Seyer24/Proyecto-Final-OC/README.md

# Proyecto-Final-OC
Oximetro Casero ESP32- MAX30102- OLED

Que es un oximetro?
El oxímetro de pulso es un dispositivo que mide el nivel de oxígeno en la sangre de forma no invasiva. Funciona mediante haces de luz que atraviesan el dedo, permitiendo estimar el porcentaje de oxígeno presente en los glóbulos rojos. 
imagen

Lista de materiales:
imagen

Explicacion de componentes:
imagen

Circuito:

imagen

Prototipo en Protoboard:

imagen

Prototipo Final:

imagen

Conclusion:

En conclusión, este proyecto evidencia como los avances en ingeniería han permitido desarrollar dispositivos médicos accesibles y funcionales en cuanto el monitoreo de signos vitales.
Dispositivos como el oxímetro de pulso, aunque aparentemente simples, permiten evaluar parámetro esenciales para la salud y apoyar la detección y seguimiento de alteraciones clínicas en millones de personas. 
Esto nos demuestra el impacto que la tecnología puede tener en la medicina y en el acceso al cuidado de la salud. 
Esto da como resultado una armonía entre proyectos IoT y la medicina. Ya que cualquier persona podría crear proyectos relacionados con la medicina y poder obtener respuestas a padecimientos con la ayuda tecnológica.
