Seyer24/Proyecto-Final-OC/Oximetro ESP32.pdf

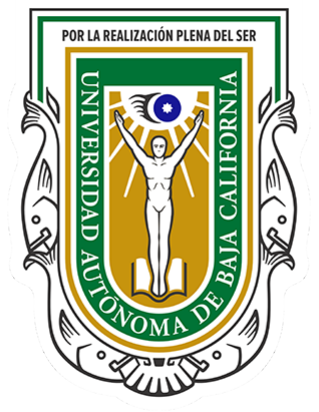
[picture p23: figure]

### Universidad Autónoma de Baja California (UABC)

Facultad de Ciencias de la Ingeniería y Tecnología (FCITEC)

Ingeniería en Desarrollo de Software

# Proyecto Final

## Monitor Cardíaco IoT con ESP32 y MAX30102

Asignatura: Organización de Computadoras

Semestre: 2026-1

Grupo: Grupo 534

Profesor: M.C. Jose Manuel Muñóz Contreras

Alumno: Reyes Gonzalez Arath — 1293182

Valle de las Palmas, Baja California, 13 de mayo de 2026

### Resumen

En este proyecto se diseño e implemento un monitor cardiaco portatil basado en el microcontrolador ESP32 [1] y el sensor optico MAX30102 [2], capaz de medir la frecuencia cardiaca (BPM) y la saturacion de oxigeno en sangre (SpO2) mediante fotopletismografia [3]. El sistema muestra los resultados en tiempo real sobre una pantalla OLED SSD1306 [4] mediante el protocolo I2C [5], y transmite los datos hacia Google Sheets a traves de WiFi y un Google Apps Script [6]. Adicionalmente, el ESP32 actua como ser-

vidor web embebido que expone un dashboard accesible desde cualquier dispositivo en la misma red [7]. El dispositivo evoluciono desde un prototipo en protoboard hasta una

version portatil alimentada por una bateria LiPo de 3.7V, un modulo cargador TP4056
[8] y un convertidor elevador MT3608 [9] que suministra 5V regulados al ESP32.

### Abstract

This project involved the design and implementation of a portable cardiac monitor based on the ESP32 microcontroller and the MAX30102 optical sensor, capable of measuring heart rate (BPM) and blood oxygen saturation (SpO2) through photoplethys-

mography. The system displays real-time results on an SSD1306 OLED screen via the I2C protocol and transmits data to Google Sheets through WiFi and a Google Apps Script. Additionally, the ESP32 acts as an embedded web server exposing a real-time dashboard. The device evolved from a breadboard prototype to a portable version powered by a 3.7V LiPo battery, a TP4056 USB-C charging module, and an MT3608 boost converter supplying 5V to the ESP32.

Palabras clave: MAX30102, ESP32, IoT, BPM, SpO2, OLED, I2C, Google Sheets, LiPo.

1

### Tabla de Contenido

1. Introducción | 4
2. Objetivos | 4
3. Marco Teórico | 5
4. Materiales y Equipos | 7
5. Diseño del Sistema | 8
6. Metodología y Desarrollo | 9
7. Resultados y Discusión | 14

2

8. Problemas Encontrados y Soluciones | 17
9. Conclusión | 17

3

Organización de Computadoras – UABC FCITEC Proyecto Final: Monitor Cardiaco IoT

### 1. Introducción

El monitoreo de signos vitales ha sido historicamente una tarea restringida al ambito clinico, requiriendo equipos costosos y personal especializado. Sin embargo, la convergencia entre microcontroladores de bajo costo con conectividad inalambrica integrada, sensores opticos miniaturizados y plataformas de almacenamiento en la nube ha democratizado el acceso a esta tecnologia, permitiendo la construccion de dispositivos medicos orientados al Internet de las Cosas (IoT).

El presente proyecto integra el microcontrolador ESP32 [1] con el sensor MAX30102 [2], un dispositivo de fotopletismografia (PPG) que utiliza LEDs infrarrojos y rojos para detectar variaciones en la absorcion de luz producidas por el flujo sanguineo [3].

Esta tecnica permite estimar de forma no invasiva tanto la frecuencia cardiaca como la saturacion de oxigeno en sangre periferica (SpO2), dos indicadores fundamentales del

estado cardiovascular y respiratorio del paciente.

Desde la perspectiva de la Organizacion de Computadoras, el proyecto ilustra como los principios arquitectonicos de un sistema embebido —gestion de buses I2C [5], [10], control de perifericos GPIO [11], polling y comunicacion en red— se materializan en

un sistema funcional. El ciclo de desarrollo, desde la validacion en protoboard hasta un dispositivo portatil con servidor web embebido [7], reproduce fielmente el proceso

de ingenieria de hardware embebido en proyectos reales.

### 2. Objetivos

### 2.1 Objetivo general

Disenar, implementar y validar un sistema embebido portatil de monitoreo cardiaco no invasivo que, mediante el microcontrolador ESP32 [1] y el sensor MAX30102 [2], adquiera senales de fotopletismografia [3] para calcular la frecuencia cardiaca promedio y la SpO2, visualice los resultados en una pantalla OLED SSD1306 [4] en tiempo real y los transmita a Google Sheets [6] mediante WiFi; superando los retos de soldadura confiable, calibracion iterativa del firmware [12] e integracion del sistema de alimentacion portatil [8], [9].

### 2.2 Objetivos específicos

Configurar Arduino IDE 2.3.8 con el soporte ESP32 [7] y las librerias Adafruit_SSD1306

[13], Adafruit_GFX [14], MAX30105 [12] y ArduinoJson [15].

2026-1 | 4

Establecer comunicacion I2C [5] usando GPIO21 (SDA) y GPIO22 (SCL) [10], [11].

Ajustar iterativamente el algoritmo checkForBeat y calculo de SpO2 [2], [12].

Disenar una maquina de estados con cuatro fases: espera, medicion de 60 s, presentacion y transmision de datos.

Integrar WiFi para Google Sheets [6] y dashboard web embebido [7].

Evolucionar el prototipo a dispositivo portatil con bateria LiPo, TP4056 [8] y MT3608 [9].

### 2.3 Competencias a desarrollar

Aplicar principios de arquitectura de computadoras en sistemas embebidos con bus I2C [5].

Integrar hardware y software para adquisicion, procesamiento y transmision de senales biomedicas en IoT.

Resolver problemas practicos de fabricacion: soldaduras, distribucion de potencia y seleccion de componentes.

Documentar tecnicamente el proceso iterativo de desarrollo hasta la version portatil.

### 3. Marco Teórico

### 3.1 Microcontrolador ESP32 y configuración de pines GPIO

El ESP32 es un sistema en chip (SoC) desarrollado por Espressif Systems que integra un procesador Xtensa LX6 de doble nucleo a 240 MHz, 520 KB de SRAM, conectividad WiFi IEEE 802.11 b/g/n y Bluetooth 4.2 [1]. Dispone de 34 pines GPIO programables con funciones multiplexadas que incluyen I2C, SPI, UART, ADC y PWM [11].

Para este proyecto se utilizaron GPIO21 y GPIO22 como bus I2C principal. Esta eleccion no es arbitraria: el Technical Reference Manual del ESP32 [16] establece que estos

pines son los predeterminados para el periferico I2C 0, lo que significa que el framework de Arduino para ESP32 [7] los inicializa automaticamente con Wire.begin() sin

necesidad de especificar pines adicionales, reduciendo conflictos con otras funciones del chip. El pin VIN acepta entre 4.5V y 5.5V y alimenta el regulador lineal interno que genera los 3.3V para el nucleo y los perifericos [1].

### 3.2 Sensor MAX30102 — Fotopletismografía

El MAX30102 es un modulo integrado de oximetria de pulso y monitoreo de frecuencia cardiaca [2]. Incorpora dos LEDs (rojo a 660 nm e infrarrojo a 880 nm), un fotode-

tector de alta sensibilidad y electronica de acondicionamiento en un encapsulado de 5.6 mm × 3.3 mm. La comunicacion es por I2C en la direccion fija 0x57.

El principio se basa en la fotopletismografia (PPG), tecnica no invasiva que mide variaciones en el volumen sanguineo mediante absorcion diferencial de luz [3]. La libreria MAX30105 de SparkFun [12], disponible en GitHub, implementa el algoritmo

maxim_heart_rate_and_oxygen_saturation() para calcular SpO2 y checkForBeat() para deteccion de latidos.

### 3.3 Protocolo I2C y justificación de su uso

El bus I2C (Inter-Integrated Circuit) es un protocolo serie sincrono de dos hilos — SDA (datos) y SCL (reloj)— desarrollado originalmente por Philips Semiconductors [5]. Permite conectar hasta 128 dispositivos en el mismo bus, cada uno identificado por

una direccion unica de 7 bits.

La eleccion de I2C sobre SPI se justifica por dos razones: reduce a dos las lineas de senal necesarias independientemente del numero de dispositivos, simplificando el cableado en la perfboard; y el ESP32 asigna GPIO21/GPIO22 al bus I2C 0 por defecto [10], eliminando configuracion adicional. En este proyecto, la OLED opera en 0x3C y el MAX30102 en 0x57, coexistiendo sin interferencia [2], [4].

### 3.4 Pantalla OLED SSD1306

La pantalla OLED SSD1306 de 128 × 64 pixeles [4] opera con consumo ultrabajo (tipicamente menor a 20 mA), adecuado para dispositivos alimentados por bateria. Se gestiona mediante Adafruit_SSD1306 [13] y Adafruit_GFX [14], que abstraen operaciones graficas sobre un buffer en RAM volcado con display.display().

### 3.5 Sistema de alimentación portátil

El TP4056 gestiona la carga de baterias LiPo en modo CC/CV, aceptando entrada USB-C de 4.5V a 5.5V [8]. Su salida directa (3.2V–4.2V) es insuficiente para el VIN del ESP32 que requiere minimo 4.5V [1]. El convertidor MT3608 [9] eleva este voltaje a

5.0V estables, configurados mediante potenciometro, garantizando operacion correcta incluso con bateria parcialmente descargada.

### 3.6 Backend IoT: Google Apps Script y servidor web embebido

Google Apps Script [6] permite desplegar un endpoint HTTP publico con doPost()

que recibe JSON del ESP32 y escribe en Google Sheets, eliminando la necesidad de un servidor propio. La serializacion de datos usa ArduinoJson [15], estandar de facto para JSON en entornos Arduino con memoria limitada. La clase WebServer del core ESP32
[7] sirve paginas HTML desde PROGMEM, accesibles desde cualquier navegador en la

red local.

### 4. Materiales y Equipos

### 4.1 Hardware

Microcontrolador: ESP32 DevKit V1 de 38 pines [1]

Sensor cardiaco: MAX30102 [2]

Pantalla OLED SSD1306, 128×64 pixeles, I2C [4]

Cargador LiPo: TP4056 con conector USB-C [8]

Convertidor elevador: MT3608 boost converter [9]

Bateria LiPo: 3.7V, 400 mAh

Interruptor deslizante SPDT de 3 pines

Perfboard, cables jumper, estano 60/40, cautin de punta fina

Multimetro Fluke 87 True RMS

### 4.2 Software y servicios

Arduino IDE 2.3.8 con soporte ESP32 [7]

Adafruit_SSD1306 [13] y Adafruit_GFX [14]

MAX30105 SparkFun [12]

ArduinoJson v6 [15]

Google Sheets y Google Apps Script [6]

### 5. Diseño del Sistema

### 5.1 Arquitectura general

La arquitectura sigue un modelo de tres capas: adquisicion (MAX30102 [2]), procesamiento y visualizacion (ESP32 [1] + OLED [4]) y transmision (Google Sheets [6] + dashboard web [7]). La Figura 1 ilustra este flujo.

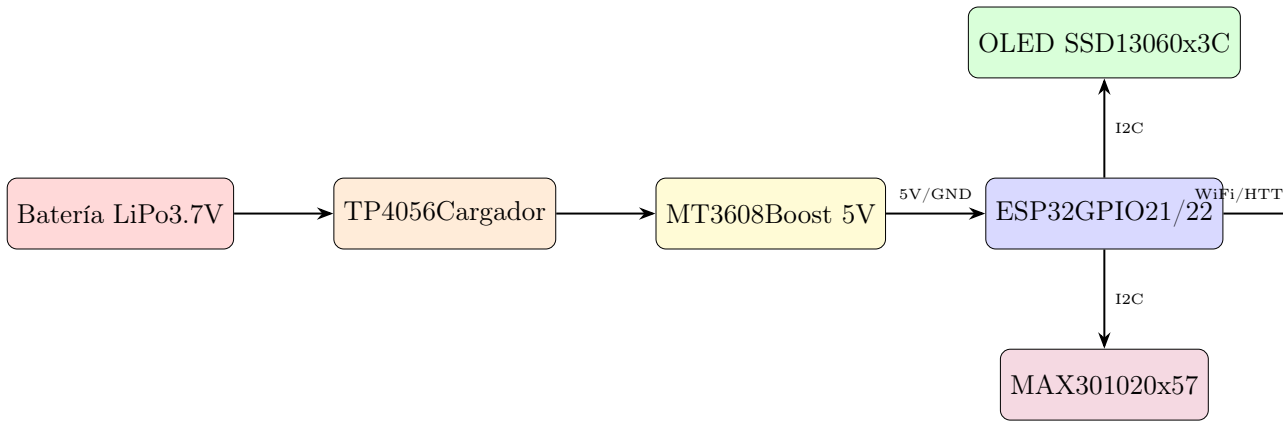
[picture p24: figure]
Batería LiPo3.7V; TP4056Cargador; MT3608Boost 5V; ESP32GPIO21/22; OLED SSD13060x3C; MAX301020x57; 5V/GND; WiFi/HTTP POST

Figura 1: Arquitectura general del sistema monitor cardíaco IoT.

### 5.2 Diagrama de conexión del circuito

El bus I2C compartido en GPIO21/GPIO22 [10] permite la coexistencia de OLED (0x3C) y MAX30102 (0x57) [5]. El interruptor SPDT interrumpe unicamente el positivo

del TP4056, manteniendo la bateria siempre conectada al cargador.

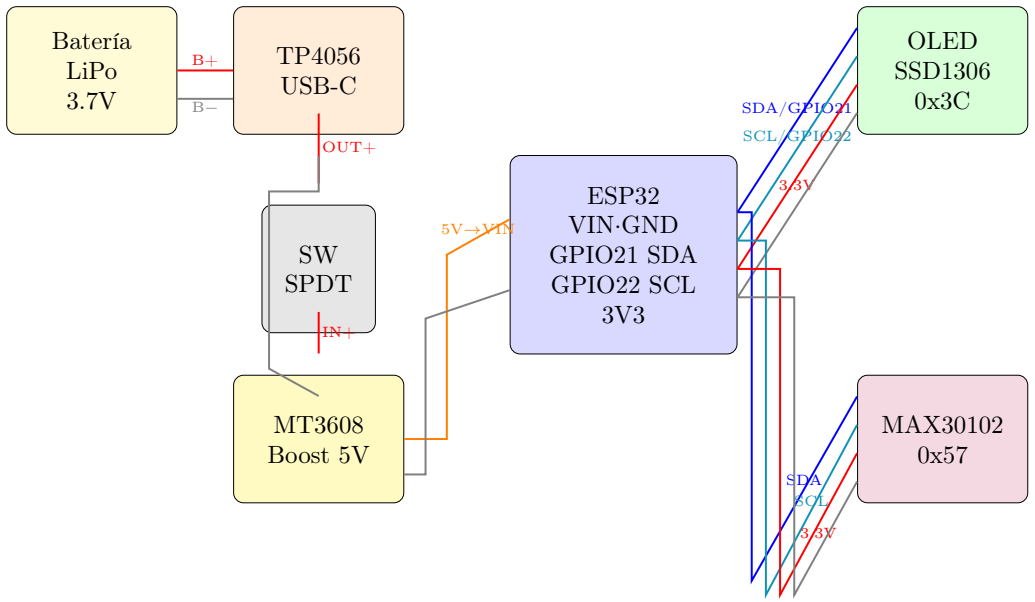
[picture p25: figure]
Batería LiPo 3.7V; TP4056 USB-C; SW SPDT; MT3608 Boost 5V; ESP32 VIN·GND GPIO21 SDA GPIO22 SCL 3V3; OLED SSD1306 0x3C; MAX30102 0x57; OUT+; 5V→VIN; SDA/GPIO21; SCL/GPIO22; SDA; SCL

Figura 2: Diagrama completo de conexión del sistema monitor cardíaco portátil.

### 5.3 Justificación de la selección de pines y módulos

Los pines GPIO21 y GPIO22 se seleccionaron porque el ESP32 los asigna al bus I2C 0 de forma predeterminada [10], [16], evitando conflictos con otras funciones multiplexadas [11] y simplificando la inicializacion con Wire.begin(21, 22). Los perifericos

se alimentan desde el pin 3.3V del ESP32, no directamente desde la bateria, porque el regulador interno del chip garantiza voltaje estable independientemente del nivel de carga, critico para la calibracion optica del MAX30102 [2], [3].

### 6. Metodología y Desarrollo

### 6.1 Fase 1 — Primeros prototipos en protoboard

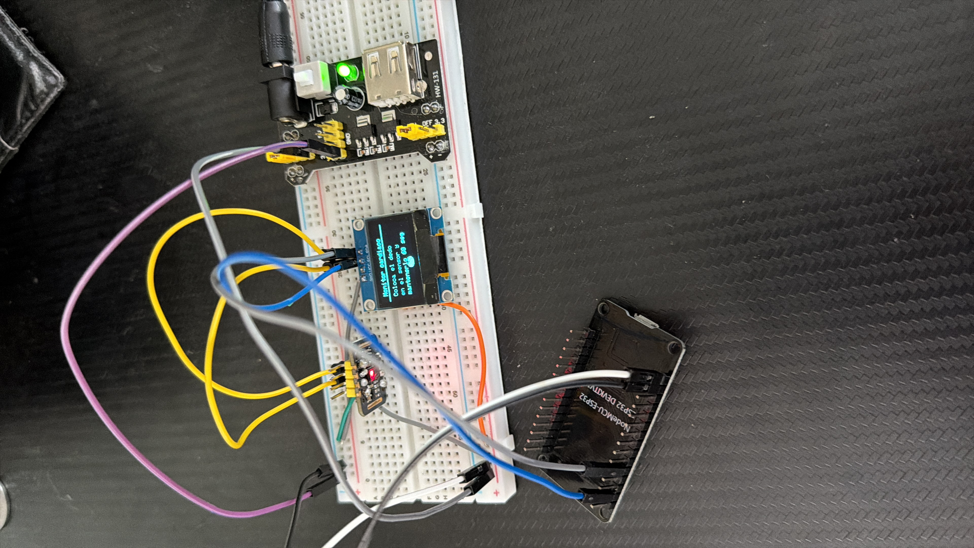
[picture p26: figure]
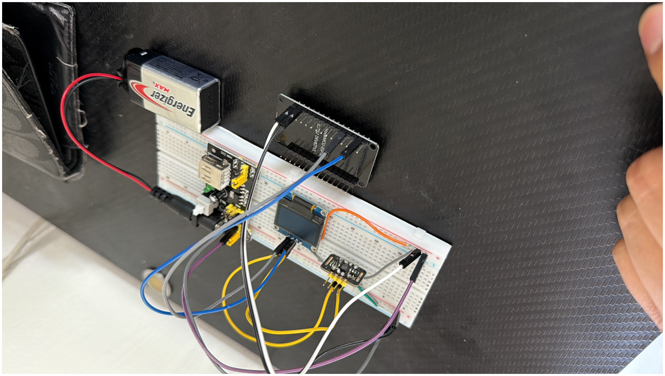
[picture p27: figure]

(a) Primera conexion en protoboard. | (b) Verificacion del funcionamiento inicial.

Figura 3: Primeros prototipos funcionales en protoboard.

### 6.2 Fase 2 — Configuración del entorno de desarrollo

1. Instalacion del soporte ESP32 en Arduino IDE 2.3.8 [7].
2. Instalacion de librerias: Adafruit_SSD1306 [13], Adafruit_GFX [14], MAX30105 [12],

ArduinoJson [15].

3. Escaneo I2C confirmo 0x3C (OLED) [4] y 0x57 (MAX30102) [2].
4. Primer upload con boton BOOT en modo de descarga manual.

### 6.3 Fase 3 — Ajuste iterativo del firmware

El firmware original llenaba el buffer sin dedo en setup(), produciendo BPM = 0. La solucion fue calibrarSensor() que espera IR > 30,000 [12].

Cuadro 1: Evolución de la configuración del sensor MAX30102 [2].

Parámetro | Inicial | Final | Justificación
Brillo LED | 60 | 25 | IR saturaba; sin deteccion de picos
Sample ave- rage | 4 | 4 | Con 8, la senal PPG se aplanaba [3]
Sample rate | 100 Hz | 200 Hz | Mayor resolucion temporal
Umbral | IR
min. | 50,000 | 30,000 | Detecta dedo con menor presion
Umbral | IR
max. | — | 200,000 | Evita saturacion por compresion excesiva
Rango BPM | 20–255 | 40–180 | Filtra valores fuera del rango fisiologico

### 6.4 Fase 4 — Máquina de estados

1 enum Estado { ESPERANDO , MIDIENDO , MOSTRANDO_RESULTADO , SUBIENDO };

2
3 | void loop () {
4 | server . handleClient () ; | // atiende peticiones web
5 | long irValue = particleSensor . getIR () ;
6 | bool dedoPresente = ( irValue > 30000 && irValue < 200000) ;

7
8 | switch ( estadoActual ) {
9 | case ESPERANDO :
10 | mostrarEsperando () ;
11 | if ( dedoPresente ) { inicioMedicion = millis () ;
estadoActual = MIDIENDO ; }
12 | break ;

13 | case MIDIENDO :
14 | if (! dedoPresente ) { estadoActual = ESPERANDO ; break ; }
15 | if ( millis () - inicioMedicion >= 60000)
| estadoActual = MOSTRANDO_RESULTADO ;
16 | break ;
17 | case MOSTRANDO_RESULTADO :
18 | mostrarResultado () ; delay (4000) ; estadoActual = SUBIENDO ;
| break ;
19 | case SUBIENDO :
20 | if ( wifiOk && beatAvg >0) subirDatos ( beatAvg , spo2Value );
21 | estadoActual = ESPERANDO ; break ;
22 | }
23 | }

Listing 1: Estructura de la máquina de estados del firmware.

### 6.5 Fase 5 — Google Sheets y servidor web embebido

Se configuro Apps Script [6] como endpoint HTTP publico. El ESP32 serializa con ArduinoJson [15] y envia por HTTP POST:

1 | StaticJsonDocument <256 > doc ;
2 | doc [" nombre "] | = " Carmen ";
3 | doc [" baja "] | = bpmMin ;
4 | doc [" alta "] | = bpmMax ;
5 | doc [" promedio "] = promedio ;
6 | doc [" spo2 "] | = spo2 ;
7 | String body ;
8 | serializeJson ( doc , body ) ;
9 | http . POST ( body );

Listing 2: Serialización JSON y envío HTTP POST.

La clase WebServer [7] sirve el dashboard HTML desde PROGMEM, accesible en

http://{IP_ESP32}/.

### 6.6 Fase 6 — Pruebas de conexiones

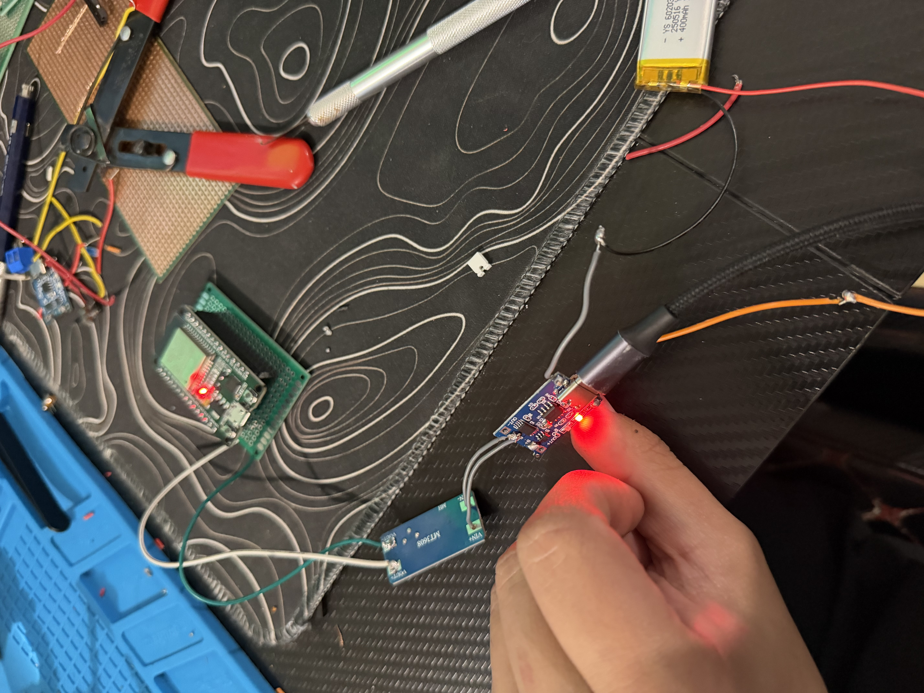
[picture p28: figure]

Figura 4: Verificacion de conexiones con multimetro Fluke 87.

### 6.7 Fase 7 — Sistema de alimentación portátil

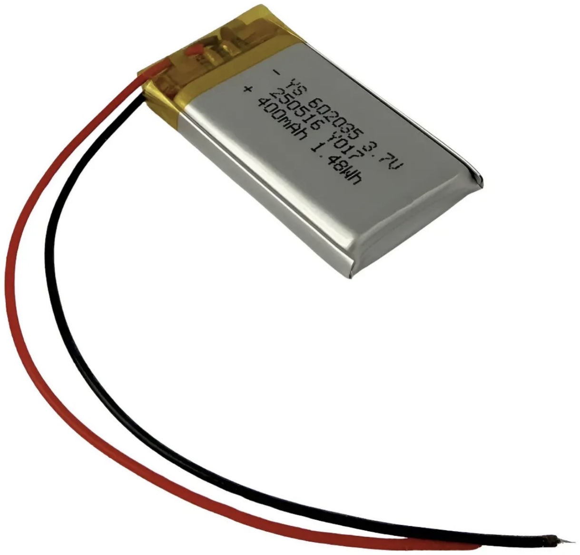
[picture p29: figure]
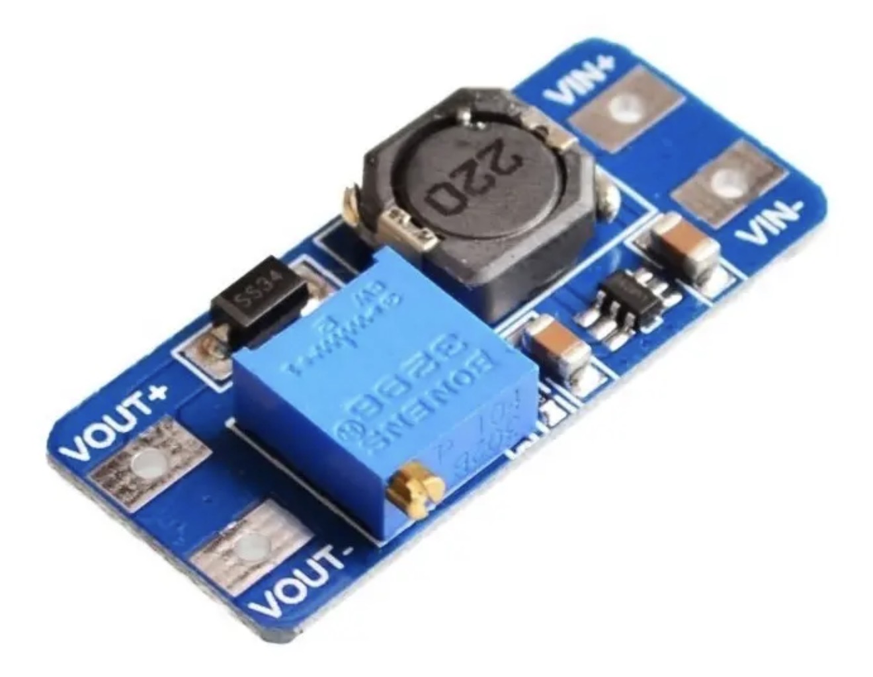
[picture p30: figure]

(a) Bateria LiPo con TP4056 [8]. | (b) Convertidor MT3608 [9] a 5V.

Figura 5: Sistema de alimentacion portatil.

### 6.8 Fase 8 — Soldadura en perfboard

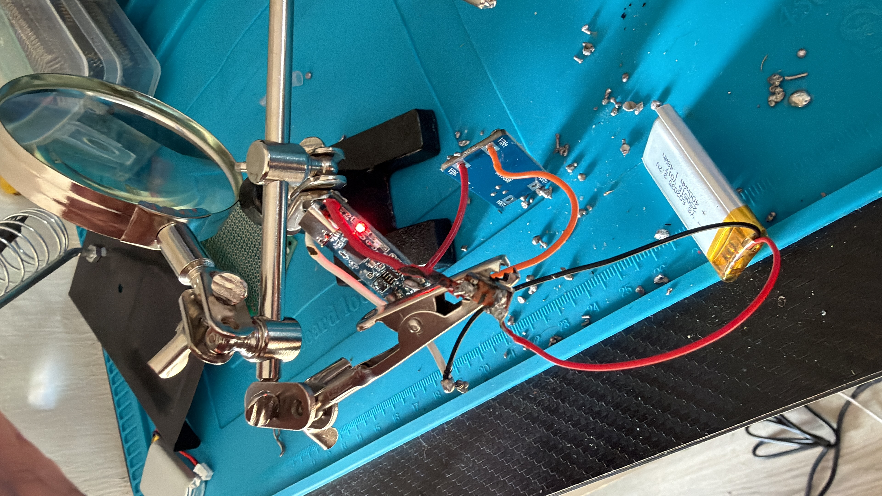
[picture p31: figure]
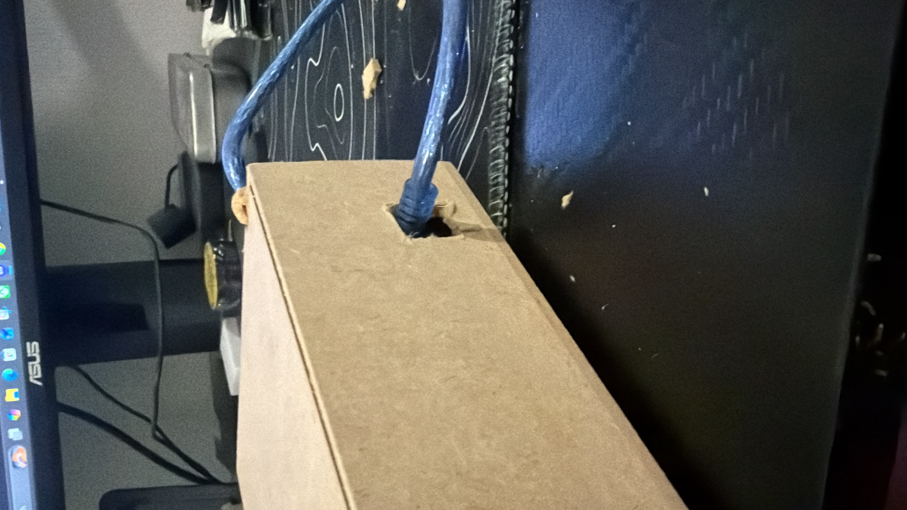
[picture p32: figure]

(a) Proceso de soldadura en perfboard. | (b) Detalles del ensamblado final.

Figura 6: Etapa de soldadura y ensamblado en perfboard.

Principales retos de esta fase:

Soldaduras frias: uniones opacas y granuladas refundidas hasta acabado brillante con verificacion de continuidad.

Cortocircuito inicial: VCC-GND conectados erróneamente; diagnosticado con multimetro (0 Ω) y corregido.

Voltaje insuficiente: TP4056 [8] directo al VIN entregaba maximo 4.2V; MT3608
[9] a 5.0V lo resolvio.

Interruptor mal ubicado: reubicado entre salida del TP4056 y entrada del MT3608.

### 7. Resultados y Discusión

### 7.1 Prototipo final

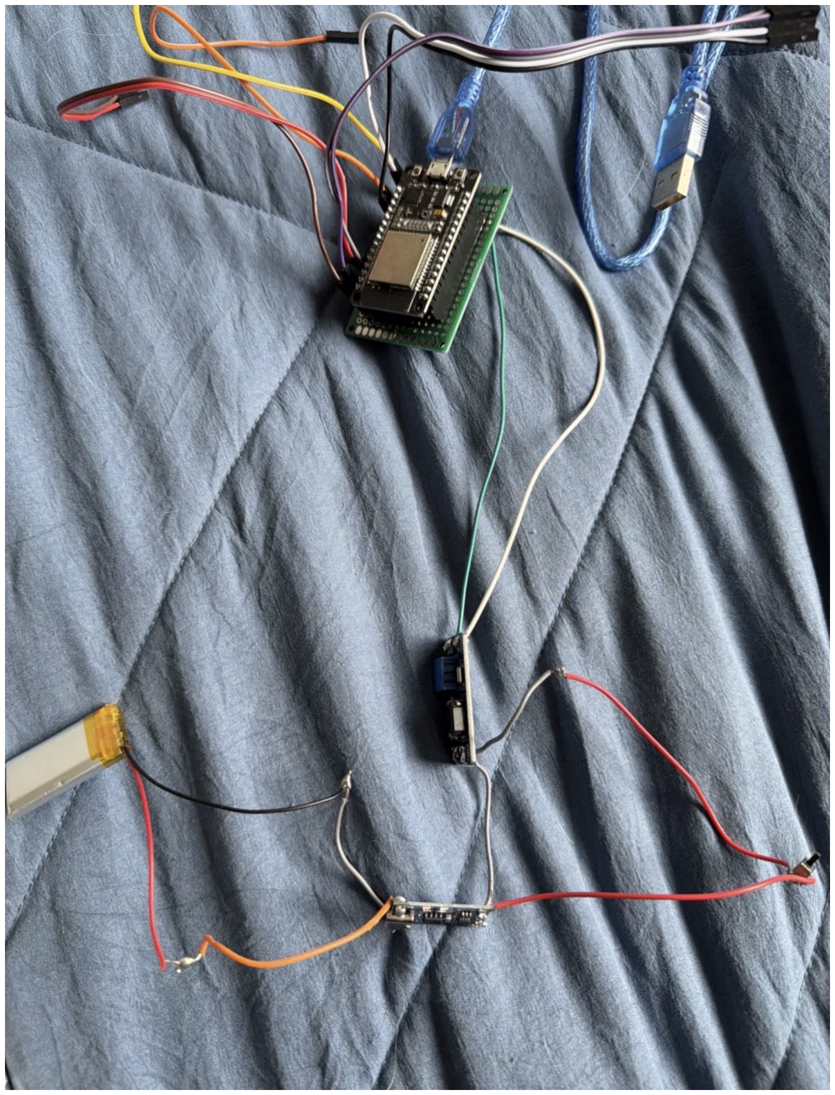
[picture p33: figure]
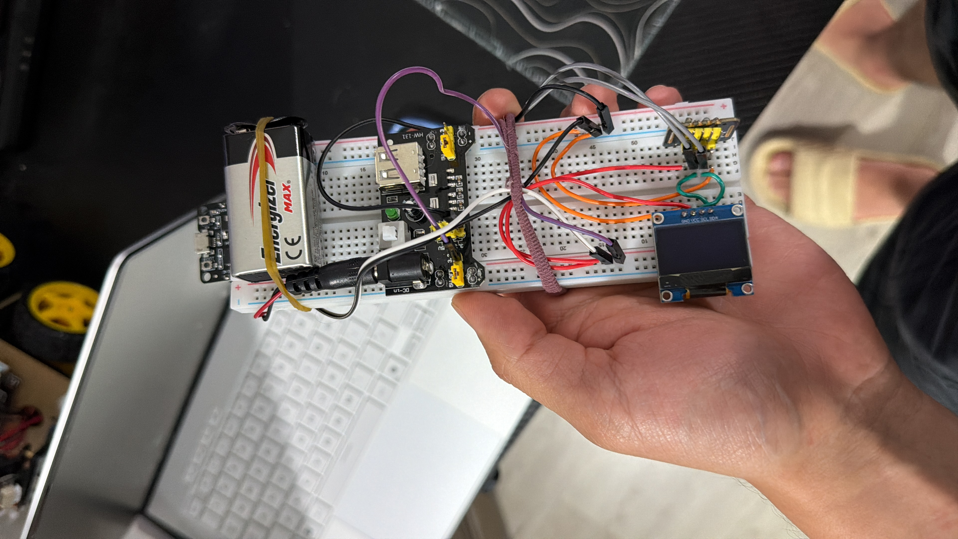
[picture p34: figure]

(a) Vista frontal del prototipo final. | (b) Vista lateral del ensamblado.

Figura 7: Prototipo final portatil del monitor cardiaco.

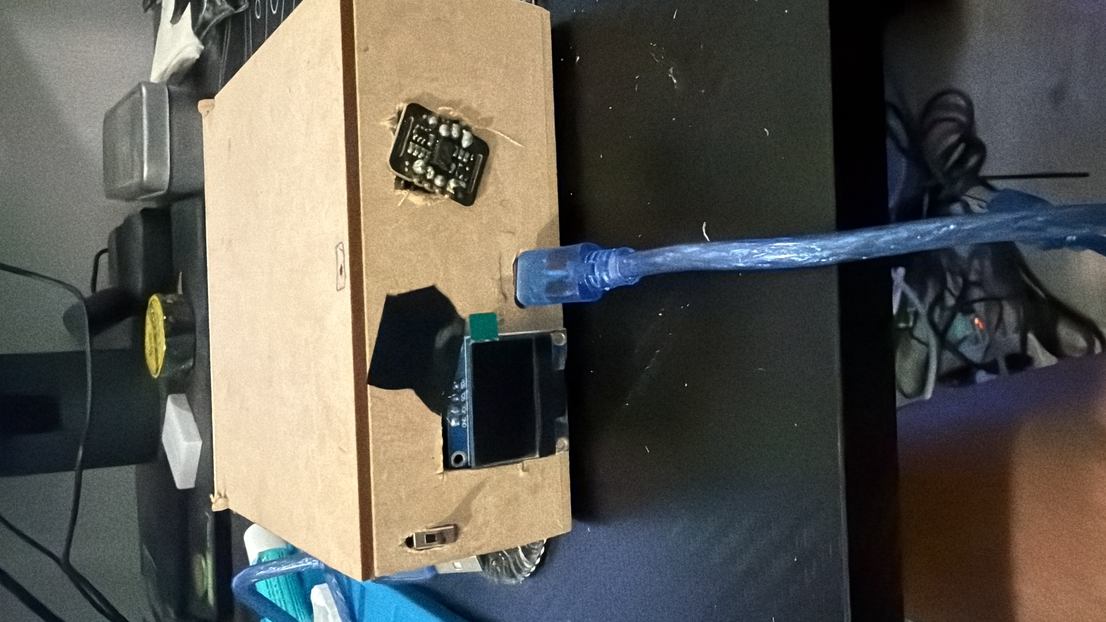
[picture p35: figure]

Figura 8: Proyecto terminado con todos los modulos integrados.

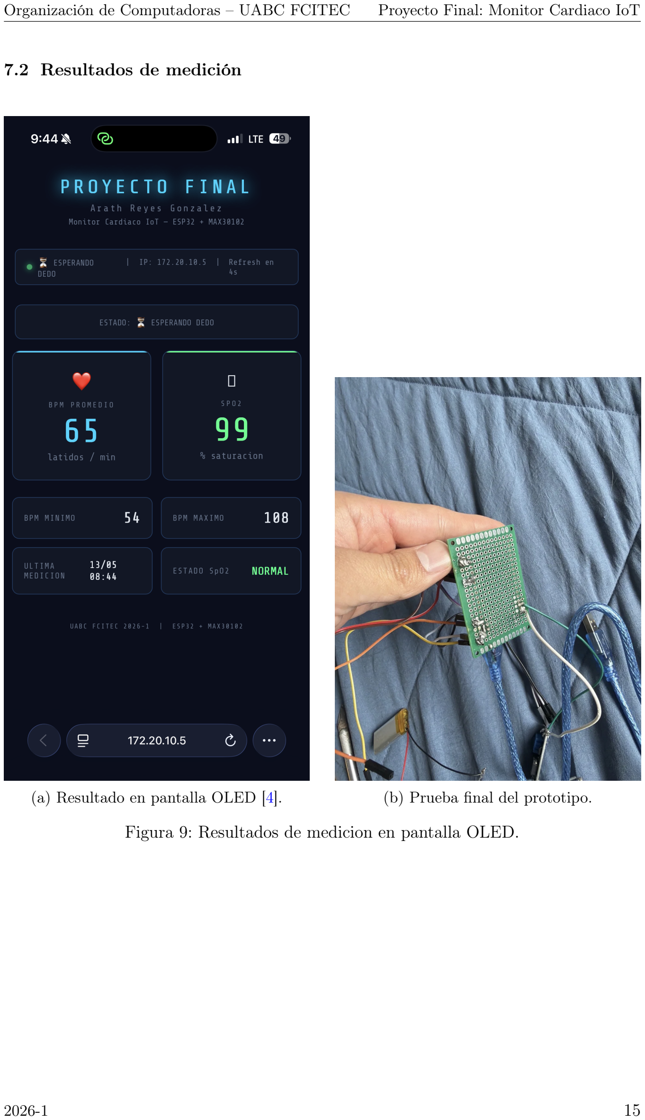
[picture p36: page 16]

### 7.2 Resultados de medición

(a) Resultado en pantalla OLED [4]. | (b) Prueba final del prototipo.

Figura 9: Resultados de medicion en pantalla OLED.

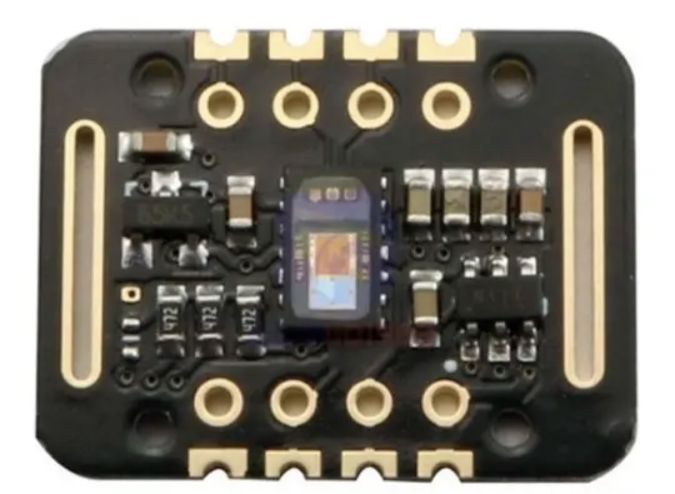
[picture p37: figure]

Figura 10: Sensor MAX30102 [2] en operacion.

El sistema detecto latidos en 95–115 BPM y SpO2 de 95–97 %, dentro del rango de normalidad clinica (95–100 %) [3]. La pantalla OLED [4] mostro correctamente la cuenta regresiva de 60 segundos con barra de progreso. El ESP32 [1] se conecto a la red WiFi 2.4 GHz y envio datos a Sheets [6] con respuesta HTTP 200. El servidor web [7]

respondio en http://{IP}/ con el dashboard actualizado por fetch JSON.

### 7.3 Análisis y discusión

1. La estabilidad mecanica del contacto del dedo fue el factor mas critico. Movimientos menores a 1 mm introducen artefactos en la senal PPG [3] que el algoritmo [12]

puede interpretar erróneamente.

2. El calculo de SpO2 [2] requiere 100 valores de buffer, implicando aproximadamente

0.5 s de latencia inicial.

3. La bateria de 400 mAh ofrece autonomia de 2–3 horas con WiFi y display activos.
4. Google Apps Script [6] presenta tiempo de respuesta variable (2–8 s) y ausencia de

autenticacion robusta, aceptables para este proyecto academico.

### 8. Problemas Encontrados y Soluciones

Cuadro 2: Registro de problemas encontrados y soluciones aplicadas.

Problema | Causa identificada | Solución aplicada

Error de boot al
cargar

ESP32 no entra en modo descarga [7]

Mantener BOOT presionado al ver “Connecting...”

BPM siempre 0 Buffer llenado sin dedo en setup()

calibrarSensor() espera IR > 30,000 [12]

SpO2 = -999 LED brillante; IR saturado en 200,000

Brillo 60→25; umbral IR max. 200,000 [2]

WiFi status 6 | Red 5 GHz incompatible [1] | Cambiar a red 2.4 GHz

ESP32 sobrecalentado

Cortocircuito VCC-GND en
perfboard

Revision de soldaduras; verificacion con multimetro

Voltaje insuficiente en VIN

TP4056 [8] directo: max. 4.2V MT3608 [9] configurado a 5.0V

HTTP 400 desde
Sheets
Script sin acceso publico [6] | Reconfigurar | a | “Cualquier
| usuario”
Soldaduras frias | Temperatura insuficiente del
cautin

Refundir hasta acabado brillan-
| te

### 9. Conclusión

El desarrollo del monitor cardiaco portatil basado en ESP32 [1] y MAX30102 [2] demos-

tro que la construccion de un dispositivo IoT funcional implica no solo el dominio del software embebido, sino un proceso iterativo de resolucion de problemas de hardware que abarca desde la correcta seleccion de librerias de codigo abierto [12], [13], [15] hasta

la ejecucion confiable de soldaduras en perfboard. El firmware requirio multiples ciclos de ajuste —modificacion de parametros del sensor [2], rediseno del algoritmo de calibracion [12] y reestructuracion del flujo de estados— antes de producir lecturas estables de BPM y SpO2 [3]. La etapa de portabilizacion evidencio que las conexiones fisicas

son tan criticas como el software: una soldadura fria o una conexion invertida basta para detener el sistema. El resultado final es un dispositivo autonomo capaz de medir, visualizar en OLED [4], registrar en Google Sheets [6] y exponer en un dashboard web embebido [7] los signos vitales del usuario, constituyendo un ejemplo concreto de como la gestion del bus I2C [5], el control de GPIO [11], los protocolos de comunicacion y la

arquitectura cliente-servidor convergen en un sistema embebido real fundamentado en los principios de organizacion de computadoras.

### Referencias Bibliográficas

[1] Espressif Systems, ESP32 Series Datasheet, v4.4, [En línea]. Disponible: https:

/ / www . espressif . com / sites / default / files / documentation / esp32 _ datasheet_en.pdf. (https://www.espressif.com/sites/default/files/documentation/esp32_datasheet_en.pdf) Accedido: 13-may-2026, Espressif Systems, 2023. dirección:

https://www.espressif.com/sites/default/files/documentation/esp32_

datasheet_en.pdf. (https://www.espressif.com/sites/default/files/documentation/esp32_datasheet_en.pdf)
[2] Maxim Integrated, MAX30102 High-Sensitivity Pulse Oximeter and Heart-Rate Sensor for Wearable Health, [En línea]. Disponible: https : / / datasheets .

maximintegrated.com/en/ds/MAX30102.pdf. (https://datasheets.maximintegrated.com/en/ds/MAX30102.pdf) Accedido: 13-may-2026, Maxim Integrated Products, 2018. dirección: https://datasheets.maximintegrated.

com/en/ds/MAX30102.pdf. (https://datasheets.maximintegrated.com/en/ds/MAX30102.pdf)
[3] J. Allen, «Photoplethysmography and its Application in Clinical Physiological Measurement,» Physiological Measurement, vol. 28, n.o 3, R1-R39, 2007, DOI: 10.1088/0967-3334/28/3/R01. doi: 10.1088/0967-3334/28/3/R01. (https://doi.org/10.1088/0967-3334/28/3/R01)
[4] Solomon Systech, SSD1306 — Advance Information: 128 x 64 Dot Matrix OLE-D/PLED Segment/Common Driver with Controller, [En línea]. Disponible: https:

//cdn-shop.adafruit.com/datasheets/SSD1306.pdf. Accedido: 13-may-2026, Solomon Systech Limited, 2008. dirección: https://cdn-shop.adafruit.com/

datasheets/SSD1306.pdf. (https://cdn-shop.adafruit.com/datasheets/SSD1306.pdf)
[5] NXP Semiconductors, «UM10204: I2C-bus Specification and User Manual, Rev. 7.0,» NXP Semiconductors, inf. téc., 2021, [En línea]. Disponible: https : / /

www . nxp . com / docs / en / user - guide / UM10204 . pdf. (https://www.nxp.com/docs/en/user-guide/UM10204.pdf) Accedido: 13-may-2026.

dirección: https://www.nxp.com/docs/en/user-guide/UM10204.pdf.
[6] Google LLC, Google Apps Script — Web Apps, Google Developers Documenta-

tion, [En línea]. Disponible: https://developers.google.com/apps-script/guides / web. (https://developers.google.com/apps-script/guides/web) Accedido: 13-may-2026, 2024. dirección: https : / / developers .

google.com/apps-script/guides/web. (https://developers.google.com/apps-script/guides/web)
[7] Espressif Systems, Arduino Core for the ESP32 — Arduino Framework for Espressif Chips, GitHub, [En línea]. Disponible: https://github.com/espressif/arduino-esp32. (https://github.com/espressif/arduino-esp32) Accedido: 13-may-2026, 2024. dirección: https://github.com/

espressif/arduino-esp32. (https://github.com/espressif/arduino-esp32)
[8] NanJing Top Power ASIC Corp, TP4056 — 1A Standalone Linear Li-Ion Battery Charger with Thermal Regulation, [En línea]. Disponible: https://dlnmh9ip6v2uc.

cloudfront.net/datasheets/Prototyping/TP4056.pdf. (https://dlnmh9ip6v2uc.cloudfront.net/datasheets/Prototyping/TP4056.pdf) Accedido: 13-may-2026, NanJing Top Power ASIC Corp, 2012. dirección: https://dlnmh9ip6v2uc.

cloudfront.net/datasheets/Prototyping/TP4056.pdf. (https://dlnmh9ip6v2uc.cloudfront.net/datasheets/Prototyping/TP4056.pdf)
[9] Aerosemi Technology, MT3608 — High Efficiency Step Up Converter, [En lí-

nea]. Disponible: https://www.olimex.com/Products/Breadboarding/BB-

PWR - 3608 / resources / MT3608 . pdf. (https://www.olimex.com/Products/Breadboarding/BB-PWR-3608/resources/MT3608.pdf) Accedido: 13-may-2026, Aerosemi Technology Co., Ltd., 2010. dirección: https : / / www . olimex . com / Products /

Breadboarding/BB-PWR-3608/resources/MT3608.pdf. (https://www.olimex.com/Products/Breadboarding/BB-PWR-3608/resources/MT3608.pdf)
[10] Espressif Systems, ESP-IDF Programming Guide — I2C Driver, Espressif Do-

cumentation, [En línea]. Disponible: https://docs.espressif.com/projects/

esp- idf/en/stable/esp32/api- reference/peripherals/i2c.html. (https://docs.espressif.com/projects/esp-idf/en/stable/esp32/api-reference/peripherals/i2c.html) Accedido: 13-may-2026, 2024. dirección: https://docs.espressif.com/projects/

esp-idf/en/stable/esp32/api-reference/peripherals/i2c.html. (https://docs.espressif.com/projects/esp-idf/en/stable/esp32/api-reference/peripherals/i2c.html)
[11] Espressif Systems, ESP-IDF Programming Guide — GPIO and RTC GPIO, Espressif Documentation, [En línea]. Disponible: https://docs.espressif.com/

projects/esp- idf/en/stable/esp32/api- reference/peripherals/gpio. html. (https://docs.espressif.com/projects/esp-idf/en/stable/esp32/api-reference/peripherals/gpio.html) Accedido: 13-may-2026, 2024. dirección: https://docs.espressif.com/

projects/esp- idf/en/stable/esp32/api- reference/peripherals/gpio.

html. (https://docs.espressif.com/projects/esp-idf/en/stable/esp32/api-reference/peripherals/gpio.html)
[12] N. Hook y SparkFun Electronics, SparkFun MAX3010x Pulse and Proximity Sensor Library, GitHub, [En línea]. Disponible: https://github.com/sparkfun/SparkFun_MAX3010x_Sensor_Library. (https://github.com/sparkfun/SparkFun_MAX3010x_Sensor_Library) Accedido: 13-may-2026, 2023. dirección:

https://github.com/sparkfun/SparkFun_MAX3010x_Sensor_Library.
[13] Adafruit Industries, Adafruit SSD1306 — Arduino Library for SSD1306 Monochrome OLED Displays, GitHub, [En línea]. Disponible: https://github.com/adafruit/Adafruit_SSD1306. (https://github.com/adafruit/Adafruit_SSD1306) Accedido: 13-may-2026, 2024. dirección: https:

//github.com/adafruit/Adafruit_SSD1306.
[14] Adafruit Industries, Adafruit GFX Library — Core Graphics Library for All Adafruit Displays, GitHub, [En línea]. Disponible: https://github.com/adafruit/Adafruit - GFX - Library. (https://github.com/adafruit/Adafruit-GFX-Library) Accedido: 13-may-2026, 2024. dirección: https : / /

github.com/adafruit/Adafruit-GFX-Library.
[15] B. Blanchon, ArduinoJson — A Simple and Efficient JSON Library for Embedded C++, GitHub, [En línea]. Disponible: https://github.com/bblanchon/ArduinoJson. (https://github.com/bblanchon/ArduinoJson) Accedido: 13-may-2026, 2024. dirección: https://github.com/

bblanchon/ArduinoJson. (https://github.com/bblanchon/ArduinoJson)
[16] Espressif Systems, «ESP32 Technical Reference Manual, v5.2,» Espressif Systems, inf. téc., 2023, [En línea]. Disponible: https : / / www . espressif . com /

sites/default/files/documentation/esp32_technical_reference_manual_ en . pdf. (https://www.espressif.com/sites/default/files/documentation/esp32_technical_reference_manual_en.pdf) Accedido: 13-may-2026. dirección: https : / / www . espressif . com /

sites/default/files/documentation/esp32_technical_reference_manual_

en.pdf. (https://www.espressif.com/sites/default/files/documentation/esp32_technical_reference_manual_en.pdf)

### Declaración de Autenticidad

El alumno que suscribe declara que el presente reporte de practica fue elaborado de manera personal y original, que los resultados reportados corresponden al trabajo experimental propio, y que las fuentes consultadas han sido debidamente citadas conforme a las normas academicas establecidas.

El uso de herramientas de inteligencia artificial generativa (ChatGPT, Claude, Copilot, etc.) para la redaccion de este documento sin declaracion explicita constituye una

falta a la integridad academica y puede derivar en las sanciones establecidas en el Reglamento Escolar de la UABC.

Reyes Gonzalez Arath — 1293182

Valle de las Palmas, Baja California, 13 de mayo de 2026

20
